Leoservice/Lighthack-for-ETC-EOS-Nomad/README.md

# Lighthack-for-ETC-EOS-Nomad
Version of Lighthack for ETC EOS Nomad and Element console with 4 buttons and 2 encoders. Button Next, last, parameter up, parameter down.
