Leoservice/Lighthack-for-ETC-EOS-Nomad/Istruzioni per programmazione Arduino Uno.odt

Istruzioni per programmazione Lighthack su Arduino uno:

Si consiglia di testare Arduino prima di iniziare l'assemblaggio del contenitore.

1. Apri lo sketch di Arduino USB_Test_sketch nell'IDE di Arduino.

2. Prima che lo sketch venga compilato, dobbiamo aggiungere del codice aggiuntivo (OSC-master.zip) in modo che Arduino sappia come parlare OSC.

3. Nell'IDE di Arduino, seleziona Sketch> Include Library> Add .ZIP Library ... e seleziona il file OSC-master.zip

4. Premere il segno di spunta per verificare il disegno.

5. Collega Arduino al tuo computer usando il cavo USB.

6. L'IDE di Arduino rileverà automaticamente il tuo Arduino Uno e lo selezionerà. Puoi verificarlo nel menu Strumenti

7. Premi la freccia per caricare il tuo sketch su Arduino.

8. Dopo che lo sketch è stato caricato, le luci di Arduino dovrebbero avere le spie L e ON fisse e la spia TX lampeggiante una volta al secondo

9. Avvia il software Eos, apri Tab 99 Diagnostics e cerca i messaggi che leggono:

"OSC USB device handshake complete [OK]"

"OSC USB device handshake initiated [ETCOSC?]"

Le spie TX e RX dovrebbero lampeggiare in sequenza una volta al secondo.

10. Premere "Incoming OSC" e dovresti vedere i messaggi ripetuti di

"[Pacchetto OSC] / eos / ping" e un numero che viene contato

Questi messaggi indicano che Arduino ed Eos stanno parlando tra loro. Anche il LED RX su Arduino dovrebbe iniziare a lampeggiare.

11.Uscire dal software Eos.

12.Ora, carica il codice box3.ino. Se hai aggiunto correttamente la libreria OSC, la verifica avrà esito positivo.

13.Premi la freccia per caricare il tuo sketch su Arduino

14. Dopo che lo sketch è stato caricato, riavvia Eos e cerca gli stessi messaggi di handshake. Nota che in questa modalità, Arduino non invia i messaggi Ping ripetuti e i LED TX / RX di Arduino lampeggeranno solo una volta.
