Leoservice/Lighthack-for-ETC-EOS-Nomad/Lista collegamenti Lighthack Leo al 10-05-2021.odt

Lighthack Leo Schema collegamenti arduino uno e hardware esterni al 10/05/2021

Lato pin analogici Arduino:

- 5V a: display VCC, display LED+5V, pin 1 del trimmer
- GND a: diplay ground, display LED - ground, RW, pin 3 del trimmer
- A0 a: encoder 1 pin B Al a encoder 1 pin A
- A2 a: encoder 2 pin B
- A3 a: encoder 2 pin B

Lato pin digitali Arduino:

- GND a pin centrali degli encoder, pin 1 dei pulsanti esterni e a pin 1 dei pulsanti dei 2 encoder
- 12 al pin 2 del pulsante NEXT
- 11 al pin 2 del pulsante LAST
- 10 ai pin 2 dei pulsanti SHIFT degli encoder
- 9 al pin 2 del pulsante DOWN
- 8 al pin 2 del pulsante UP
- 7 al pin 7 del display
- 6 al pin 6 del display
- 5 al pin 5 del display
- 4 al pin 4 del display
- 3 al pin ENABLE del display
- 2 al pin RS del display

Il pin 2 del trimmer da 10 k ohm va al pin VEE del display

Lista componenti:

- Arduino uno
- Display HD44780
- 2 x encoder
- 4 x pulsante
- 10 x condensatore 100nF
- 1 trimmer 10K ohm

Applicare un condesatore da 100nF in parallelo ai 4 pulsanti, agli encoder tra pin A-C, C-B e ai pulsanti degli encoder.

Parametri controllati: Intensity Shutter Strobe — Pan — Tilt — Zoom — Edge —Iris - Diffusion — Red Green — Blue — White — Hue - Saturatn
