Leoservice/Lighthack-for-ETC-EOS-Nomad/Schema elettrico Lighthack Leo.pdf

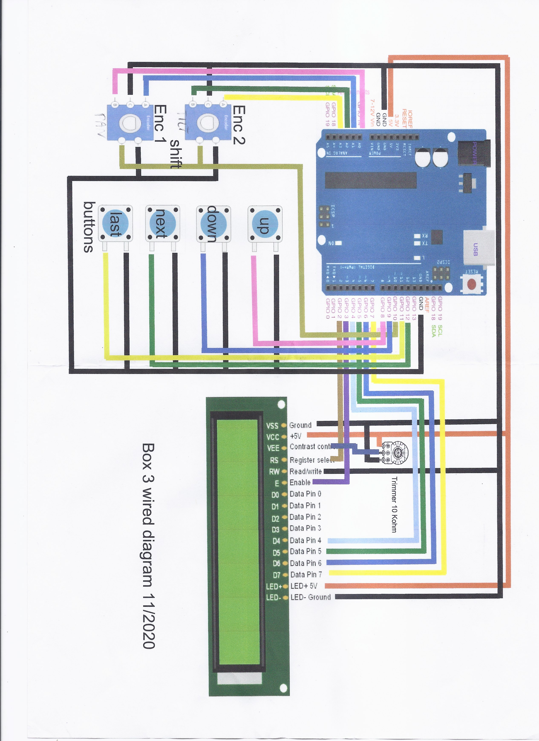
[picture p1: page 1]
