Leoservice/Lighthack-for-ETC-EOS-Nomad/Scatola con supporti arduino al 29 genn 21.stl

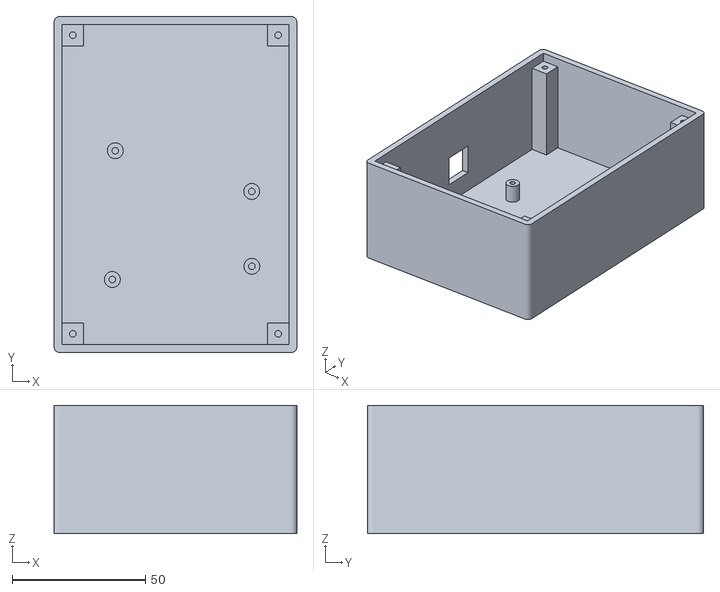
[picture p2: CAD file, 2021-05-10]
Scatola con supporti arduino al 29 genn 21.stl
91.0 x 126.0 x 48.0
