Leoservice/Lighthack-for-ETC-EOS-Nomad/lighthack manopola 12mm a 3 fori.stl

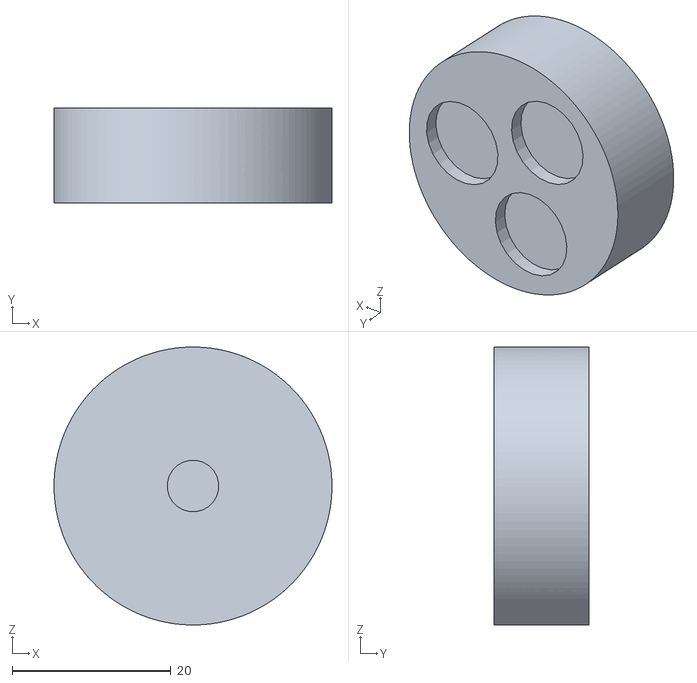
[picture p3: CAD file, 2021-05-10]
lighthack manopola 12mm a 3 fori.stl
35.0 x 12.0 x 35.0
