Leoservice/Lighthack-for-ETC-EOS-Nomad/Lighthack coperchio al 29 genn 21.stl

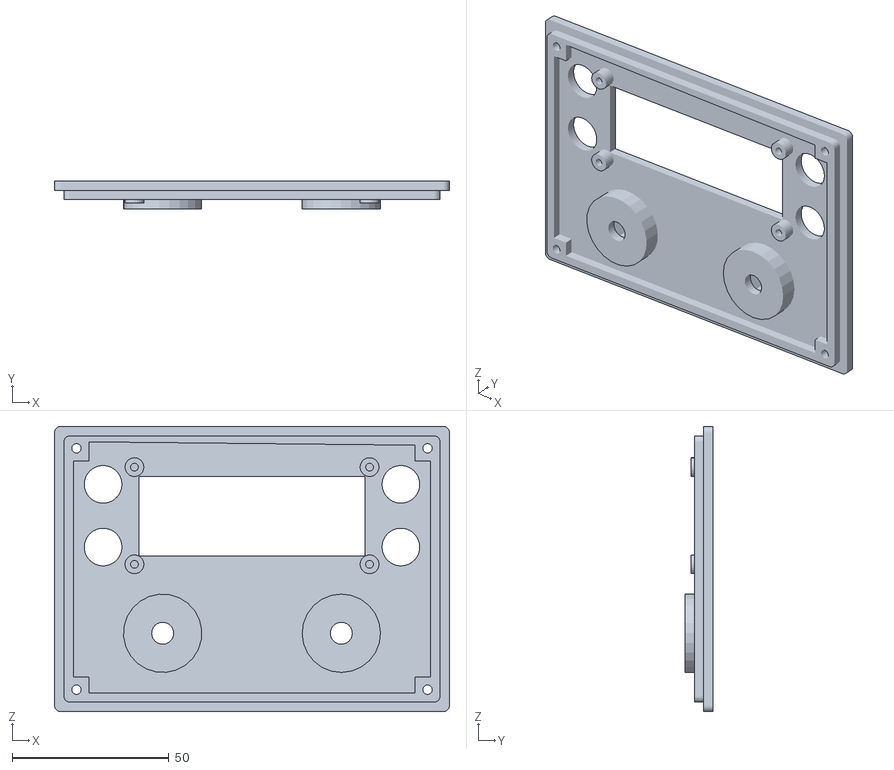
[picture p4: CAD file, 2021-05-10]
Lighthack coperchio al 29 genn 21.stl
126.0 x 9.00 x 91.0
