Leoservice/Lighthack-for-ETC-EOS-Nomad/(list of files, cad)

Other CAD files:
Lighthack coperchio al 29 genn 21.skp
Scatola con supporti arduino al 29 genn 21.skp
lighthack manopola 12mm a 3 fori.skp
